thaspdev/PATRICK/illustrations/Schema_construction_corps.png

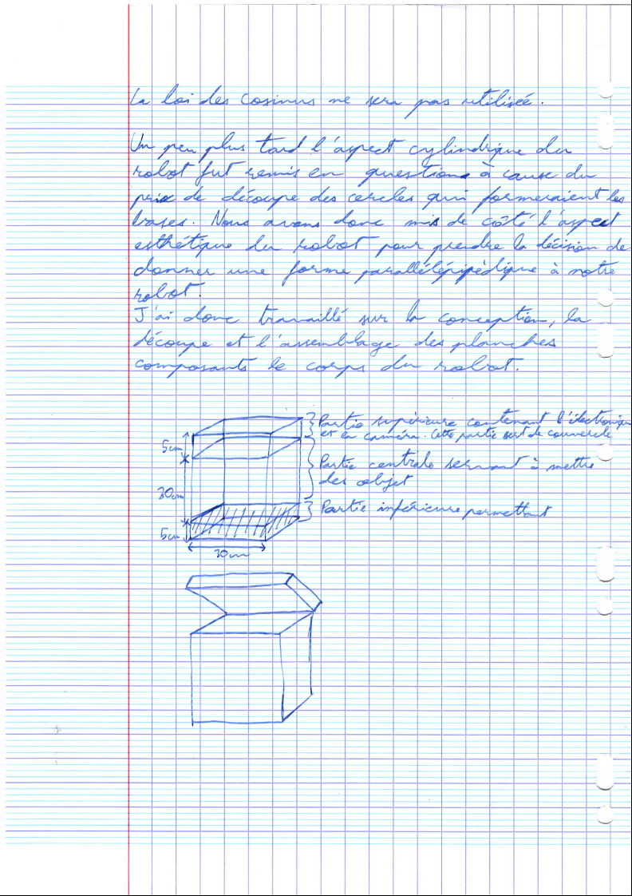
illustrations/Schema_construction_corps.png
