thaspdev/PATRICK/illustrations/Schema_construction_corps_v2.png

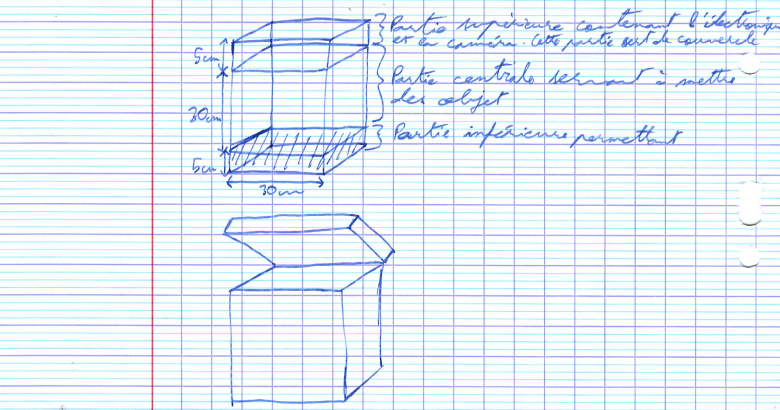
illustrations/Schema_construction_corps_v2.png
