thaspdev/PATRICK/README.md

# PATRICK le robot

Ceci est la page GitHub du projet PATRICK, un robot d'assistance à localisation par reconnaissance faciale.
