thaspdev/PATRICK/illustrations/al_kashi_synth.png

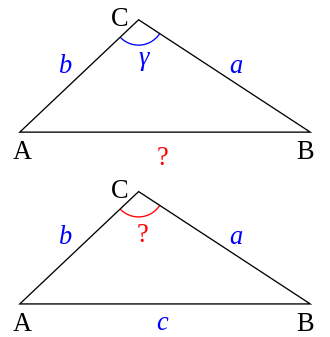
illustrations/al_kashi_synth.png
