thaspdev/PATRICK/illustrations/Raspi_poussoir_bb.png

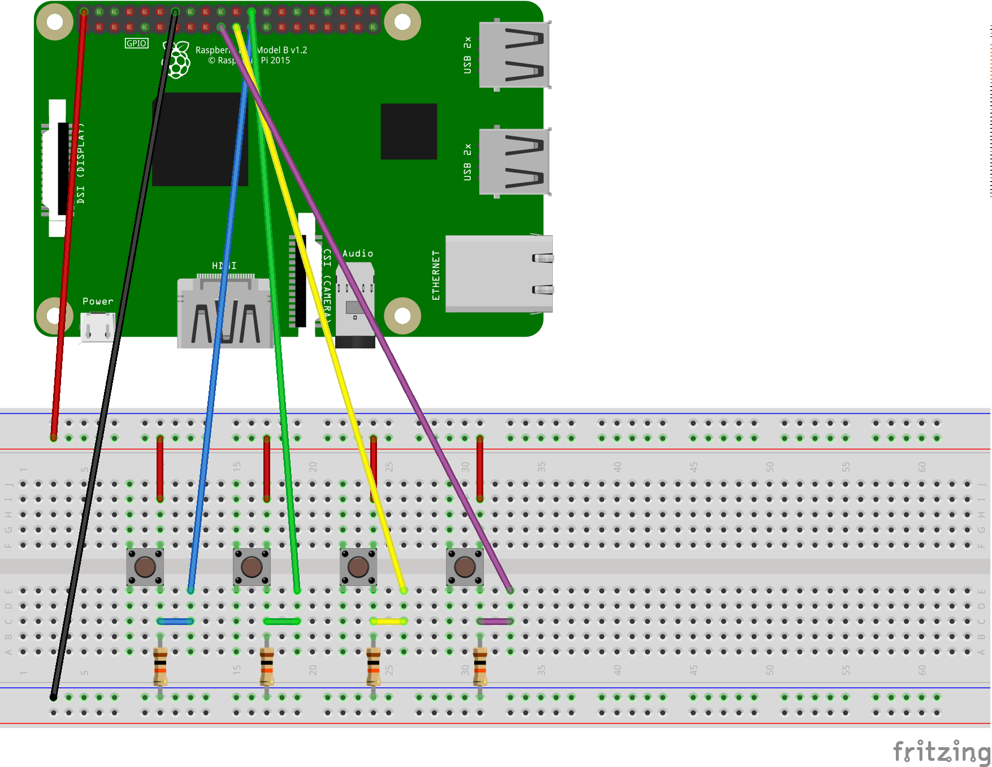
illustrations/Raspi_poussoir_bb.png
