thaspdev/PATRICK/illustrations/robot-dessous.png

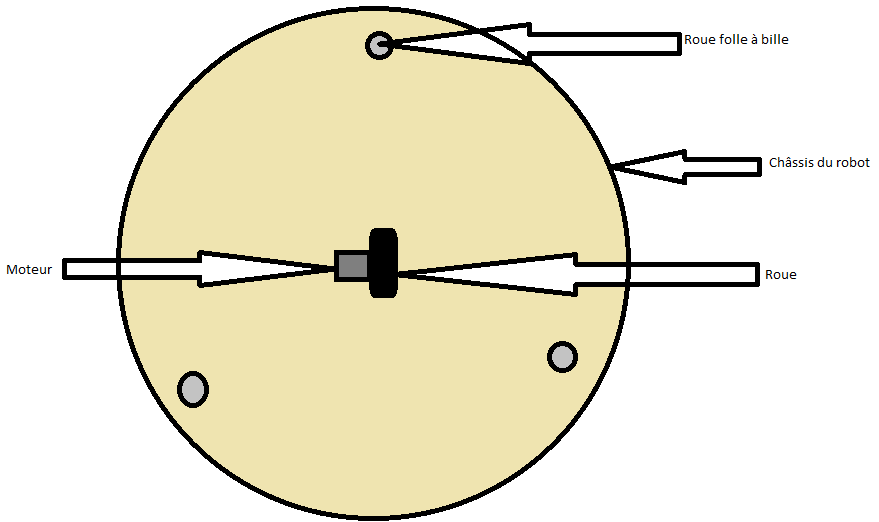
illustrations/robot-dessous.png
