thaspdev/PATRICK/illustrations/robot-instable.png

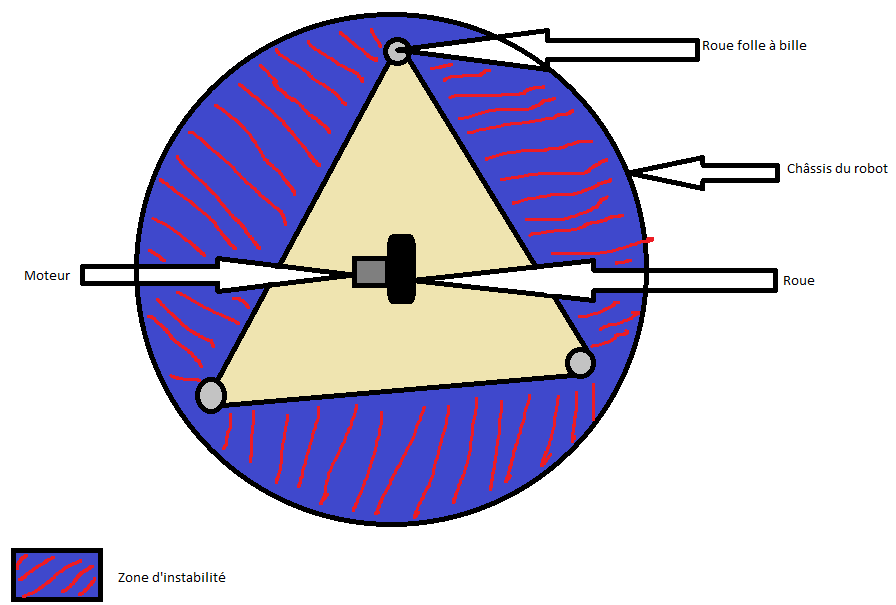
illustrations/robot-instable.png
