thaspdev/PATRICK/illustrations/Schema_al_kashi_new.png

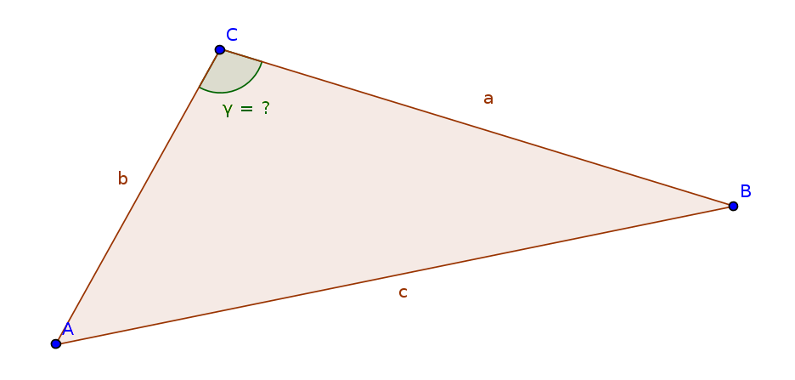
illustrations/Schema_al_kashi_new.png
