thaspdev/PATRICK/illustrations/Stepper_cablage.jpg

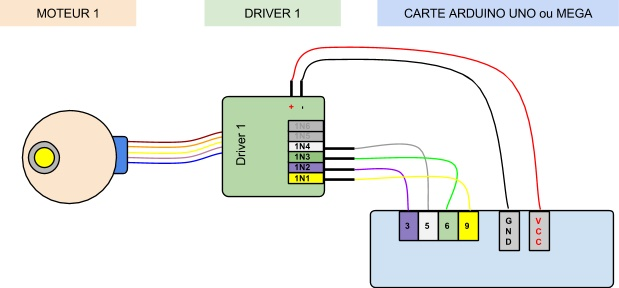
illustrations/Stepper_cablage.jpg
