thaspdev/PATRICK/illustrations/Tachymetre.png

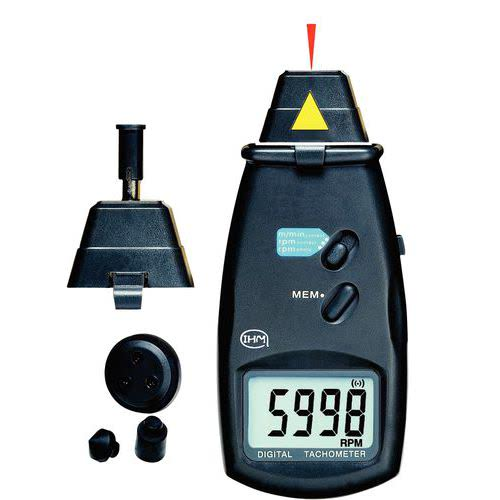
illustrations/Tachymetre.png
