thaspdev/PATRICK/ref/img/L293D_Circuit.jpg

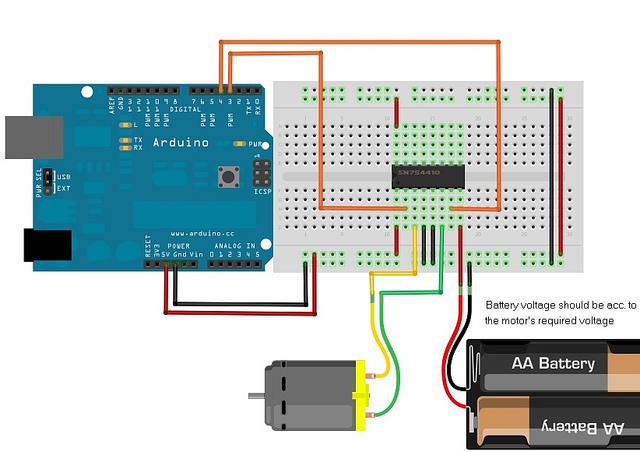
ref/img/L293D_Circuit.jpg
