thaspdev/PATRICK/circuits/Montage moteur l293d final/Montage moteur l293d final_bb.png

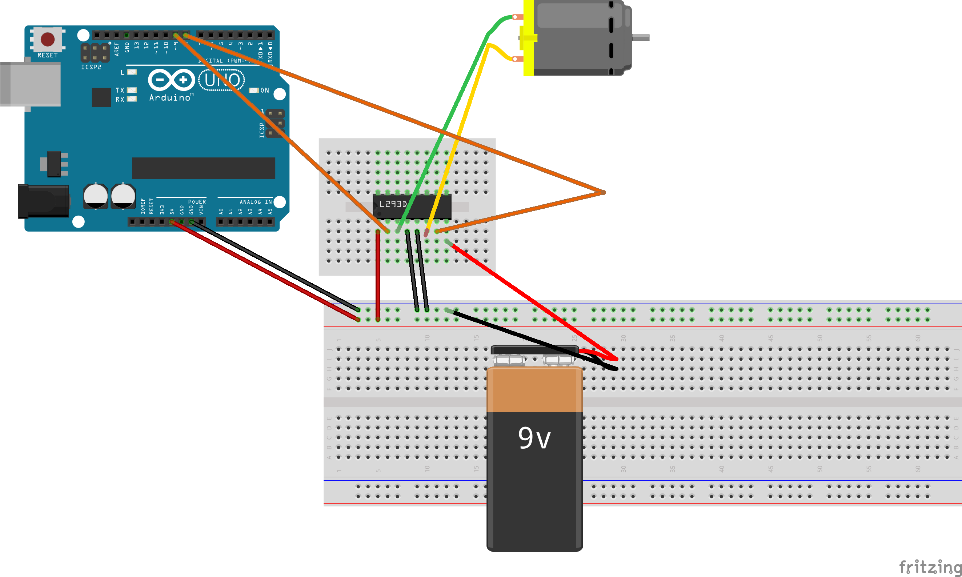
circuits/Montage moteur l293d final/Montage moteur l293d final_bb.png
