thaspdev/PATRICK/(list of files, drawings)

Other design files:
circuits/Arduino_moteur/Arduino_moteur.fzz
circuits/Arduino_servo/Arduino_servo.fzz
circuits/Montage moteur l293d final/Montage moteur l293d final.fzz
circuits/Raspi_lcd/Raspi_lcd.fzz
circuits/Raspi_poussoir/Raspi_poussoir.fzz
