thaspdev/PATRICK/(commit log)

2016-10-01 Create Liste des pins
2016-10-01 Created main file for robot (Raspberry Pi)
2016-10-02 added pins Arduino
2016-10-17 Update Liste des pins (MEGA + UNO)
2016-10-17 Update Liste des pins
2016-12-14 Create motoréducteur
2017-01-18 Added Dossier de présentation (Tex & PDF)
2017-02-20 Ajout des circuits électroniques
    [Arduino_moteur.fzz, Arduino_servo.fzz, Raspi_lcd.fzz, Raspi_poussoir.fzz]
2017-02-22 Ajout du code du Raspberry Pi et de celui de l'Arduino
2017-02-22 Ajout du code de l'Arduino
2017-03-04 Ajout du dossier de présentation en sa version finale
2017-03-08 Ajout des illustrations
2017-03-12 Montage moteur final
    [Montage moteur l293d final.fzz]
2017-03-12 Création dossier pour montage moteur
    [Montage moteur l293d final.fzz]
